rex-mcall/EST_Internship_2021/experimental_code/guiTest2/mainApp.py

from tkinter import *
import ephem
import datetime as dt
from datetime import datetime, timezone
from math import *
from functools import partial
from threading import Thread
import satelliteCalculations
from satelliteCalculations import *

class mainWindow():
    def __init__(self):
        self.master_window = Tk()
        self.master_window.title("Satellite Tracker")
        self.master_window.attributes("-fullscreen", True)
        # self.master_window.state("zoomed")

        # Top Buttons Frame ----------------------------------------------------
        self.buttons_frame = Frame(self.master_window)
        self.buttons_frame.pack(fill='y')

        self.btn_Disable = Button(self.buttons_frame, text='Disable Motors', command=self.stopMotors)
        self.btn_Disable.grid(row=0, column=0, padx=(10), pady=10)

        self.btn_Calibrate = Button(self.buttons_frame, text='Calibrate Sensors')
        self.btn_Calibrate.grid(row=0, column=1, padx=(10), pady=10)

        self.btn_Home = Button(self.buttons_frame, text='Home Motors')
        self.btn_Home.grid(row=0, column=2, padx=(10), pady=10)

        self.btn_Laser = Button(self.buttons_frame, text='Laser On/Off')
        self.btn_Laser.grid(row=0, column=3, padx=(10), pady=10)

        self.btn_closeApp = Button(self.buttons_frame, text='Exit Application', command=self.Close)
        self.btn_closeApp.grid(row=0, column=4, padx = 10, pady = 10)

        # Search Frame ----------------------------------------------------
        self.search_frame = Frame(self.master_window)
        self.search_frame.pack(fill='y')


        self.search_Text = Label(self.search_frame, text="Satellite Name:")
        self.search_Text.grid(row=0, column=0, padx=(10), pady=10)
        self.search_Entry = Entry(self.search_frame)
        self.search_Entry.grid(row=0, column=1, padx=(10), pady=10)


        self.minElev_Text = Label(self.search_frame, text="Minimum Vertex Elevation (Deg):")
        self.minElev_Text.grid(row=1, column=0, padx=(10), pady=10)
        self.minElev_Entry = Entry(self.search_frame)
        self.minElev_Entry.grid(row=1, column=1, padx=(10), pady=10)


        self.maxWait_Text = Label(self.search_frame, text="Max Wait Till Rise (Mins):")
        self.maxWait_Text.grid(row=2, column=0, padx=(10), pady=10)
        self.maxWait_Entry = Entry(self.search_frame)
        self.maxWait_Entry.grid(row=2, column=1, padx=(10), pady=10)

        self.magnitudeFilter_Text = Label(self.search_frame, text="Minimum Magnitude:")
        self.magnitudeFilter_Text.grid(row=3, column=0, padx=(10), pady=10)
        self.magnitudeFilter_Entry = Entry(self.search_frame)
        self.magnitudeFilter_Entry.grid(row=3, column=1, padx=(10), pady=10)


        self.startSearch_btn = Button(self.search_frame, text='Search', command = self.runSatelliteSearch)
        self.startSearch_btn.grid(row=4, column=1, padx=(10), pady=10)

        # motor positions frame
        self.motorInfoFrame = Frame(self.master_window)
        self.motorInfoFrame.pack(fill='y')

        self.satInfo_Label = Label(self.motorInfoFrame, text="Satellite not selected")
        self.satInfo_Label.grid(row=0, column=0, padx=(10), pady=10)

        self.motorInfo_Label = Label(self.motorInfoFrame, text="Motors not initialized")
        self.motorInfo_Label.grid(row=1, column=0, padx=(10), pady=10)

        self.master_window.after(50, func=self.updateAppInfoFrame)

        self.master_window.mainloop()




    def runSatelliteSearch(self):
        satName = self.search_Entry.get() if self.search_Entry.get() != '' else None
        minElev = int(self.minElev_Entry.get()) if self.minElev_Entry.get() != '' else None
        maxWait = dt.timedelta(minutes=int(self.maxWait_Entry.get())) if self.maxWait_Entry.get() != '' else None
        minMagnitude = int(self.magnitudeFilter_Entry.get()) if self.magnitudeFilter_Entry.get() != '' else None

        search = satelliteSearch(satNameSearch = satName, minElevSearch = minElev, maxWaitSearch = maxWait, minMagSearch = minMagnitude)
        top5Results = search.getTop5Results()
        self.searchResultButtonPopulation(top5Results)

    def searchResultButtonPopulation(self, top5Results):
        try:
            temp = self.results_Frame
        except AttributeError:
            self.results_Frame = Frame(self.master_window)
            self.results_Frame.pack(fill='y')

        for widget in self.results_Frame.winfo_children():
            widget.destroy()
        rowCounter = 0
        for satResult in top5Results:
            btn = Button(self.results_Frame, text=satResult.name, command= partial(self.resultClick, satResult))
            btn.grid(row=rowCounter, column=0)
            rowCounter = rowCounter + 1

    def resultClick(self, sat):
        try:
            self.motors.selectSatellite(sat)
            self.motors.setShouldTrack(True)
        except AttributeError:
            self.motors = stepperMotors(satellite=sat)
        try:
            temp = self.motorThread
        except AttributeError:
            self.motorThread = Thread(target=self.runMotors)
            self.motorThread.daemon = True
            self.motorThread.start()

    def runMotors(self):
        self.motors.singleStepAltAz()
    def stopMotors(self):
        self.motors.setShouldTrack(False)

    def updateAppInfoFrame(self):
        try:
            satElev =   round(self.motors.satellite.alt * toDeg, 2)
            satAz =     round(self.motors.satellite.az * toDeg, 2)
            motorElev = round(self.motors.currStepperElevation, 2)
            motorAz =   round(self.motors.currStepperAzimuth, 2)
        except AttributeError:
            self.master_window.after(50, func=self.updateAppInfoFrame)
            return

        self.satInfo_Label['text'] =   "Satellite  : [Elev={0:.2f}, Az={1:.2f}]".format(satElev, satAz)
        self.motorInfo_Label['text'] = "Motors     : [Elev={0:.2f}, Az={1:.2f}]".format(motorElev, motorAz)
        self.master_window.after(50, func=self.updateAppInfoFrame)
    def Close(self):
        self.master_window.destroy()
        try:
            self.motors.endThread()
        except Exception:
            pass
        sleep(5)
        exit(0)



mainWindow()
