rex-mcall/EST_Internship_2021/experimental_code/rpiTests/neo6mTest/gpsTest.py

import serial
import time
import string
import pynmea2

port="/dev/ttyAMA0"
ser=serial.Serial(port, baudrate=9600, timeout=0.5)
while True:
    try:
        newdata=ser.readline()
        data = newdata.decode()
        print(data)
        if data[0:6] == '$GPRMC':
            print("in if")
            newmsg = pynmea2.parse(data)
            dtObject = newmsg.datetime
            lat = newmsg.latitude
            lng = newmsg.longitude
            gps = "Latitude = " + str(lat) + "and Longitude = " + str(lng)
            print(gps)
    except KeyboardInterrupt:
        exit()
    except Exception:
        pass
