rex-mcall/EST_Internship_2021/experimental_code/rpiTests/stepperTest/stepperTestPWM.py

from time import sleep
import pigpio

DIR = 20     # Direction GPIO Pin
STEP = 21    # Step GPIO Pin


# Connect to pigpiod daemon
pi = pigpio.pi()

# Set up pins as an output
pi.set_mode(DIR, pigpio.OUTPUT)
pi.set_mode(STEP, pigpio.OUTPUT)

MODE = (14, 15, 18)   # Microstep Resolution GPIO Pins
RESOLUTION = {'Full': (0, 0, 0),
              'Half': (1, 0, 0),
              '1/4': (0, 1, 0),
              '1/8': (1, 1, 0),
              '1/16': (0, 0, 1),
              '1/32': (1, 0, 1)}
for i in range(3):
    pi.write(MODE[i], RESOLUTION['Full'][i])

pi.write(DIR, 1)  # Set direction
# Set duty cycle and frequency
pi.set_PWM_dutycycle(STEP, 128)  # PWM 1/2 On 1/2 Off
pi.set_PWM_frequency(STEP, 400)  # Pulses per second

pi.set_PWM_dutycycle(STEP, 0)
pi.stop()
