rex-mcall/EST_Internship_2021/(commit log)

2021-07-19 First conversion to inertial frame
2021-07-30 Started working on Arduino and changed some code for testing
2021-08-02 working with arduino magnetometer and troubleshooting altaz code
2021-08-04 New test code for Arduino
2021-08-04 More stepper motor tests
2021-08-05 Continued stepper motor testing
2021-08-09 working with arduino gyro
2021-08-10 Pi stepper tests
2021-08-10 steppers work on the Pi
2021-08-10 Test for motors and sat position
2021-08-10 testing az motor
2021-08-10 Fixing wile loop logic for when to step
    [integratedStepperAltAz.py]
2021-08-10 Tracking seems to work. Very jittery
    [integratedStepperAltAz.py]
2021-08-11 Fixed error when crossing 360-->0 azimuth and added documentation
    [integratedStepperAltAz.py]
2021-08-12 Fully working satellite tracking / stepper control
2021-08-18 Untested full app w/ motors
2021-08-18 Semi- working. Very slow and buggy.
    [mainApp.py]
2021-08-18 Improved search functionality and thread handling. Mostly working.
2021-08-21 pin assignments for new hardware circuitry
2021-08-21 fixing motors not working errors
    [mainApp.py]
2021-08-21 motors not working. not sure if hardware or software error
    [stepperTestRpi.py]
2021-08-25 Started assembling the final version of the code
2021-08-26 Testing on the Pi - Limit switch elev
2021-08-27 Testing homing again
2021-09-12 Added options to track Moon or jupiter/saturn
2021-09-12 Fixing edge case when switching between tracking jupiter and saturn
    [satDriver.py]
2021-09-12 Setting home angles for motors
